Kev1n8088/OshTeledongle/OshTeledongle.kicad_pcb

## KiCad design OshTeledongle.kicad_pcb (2026-07-14)

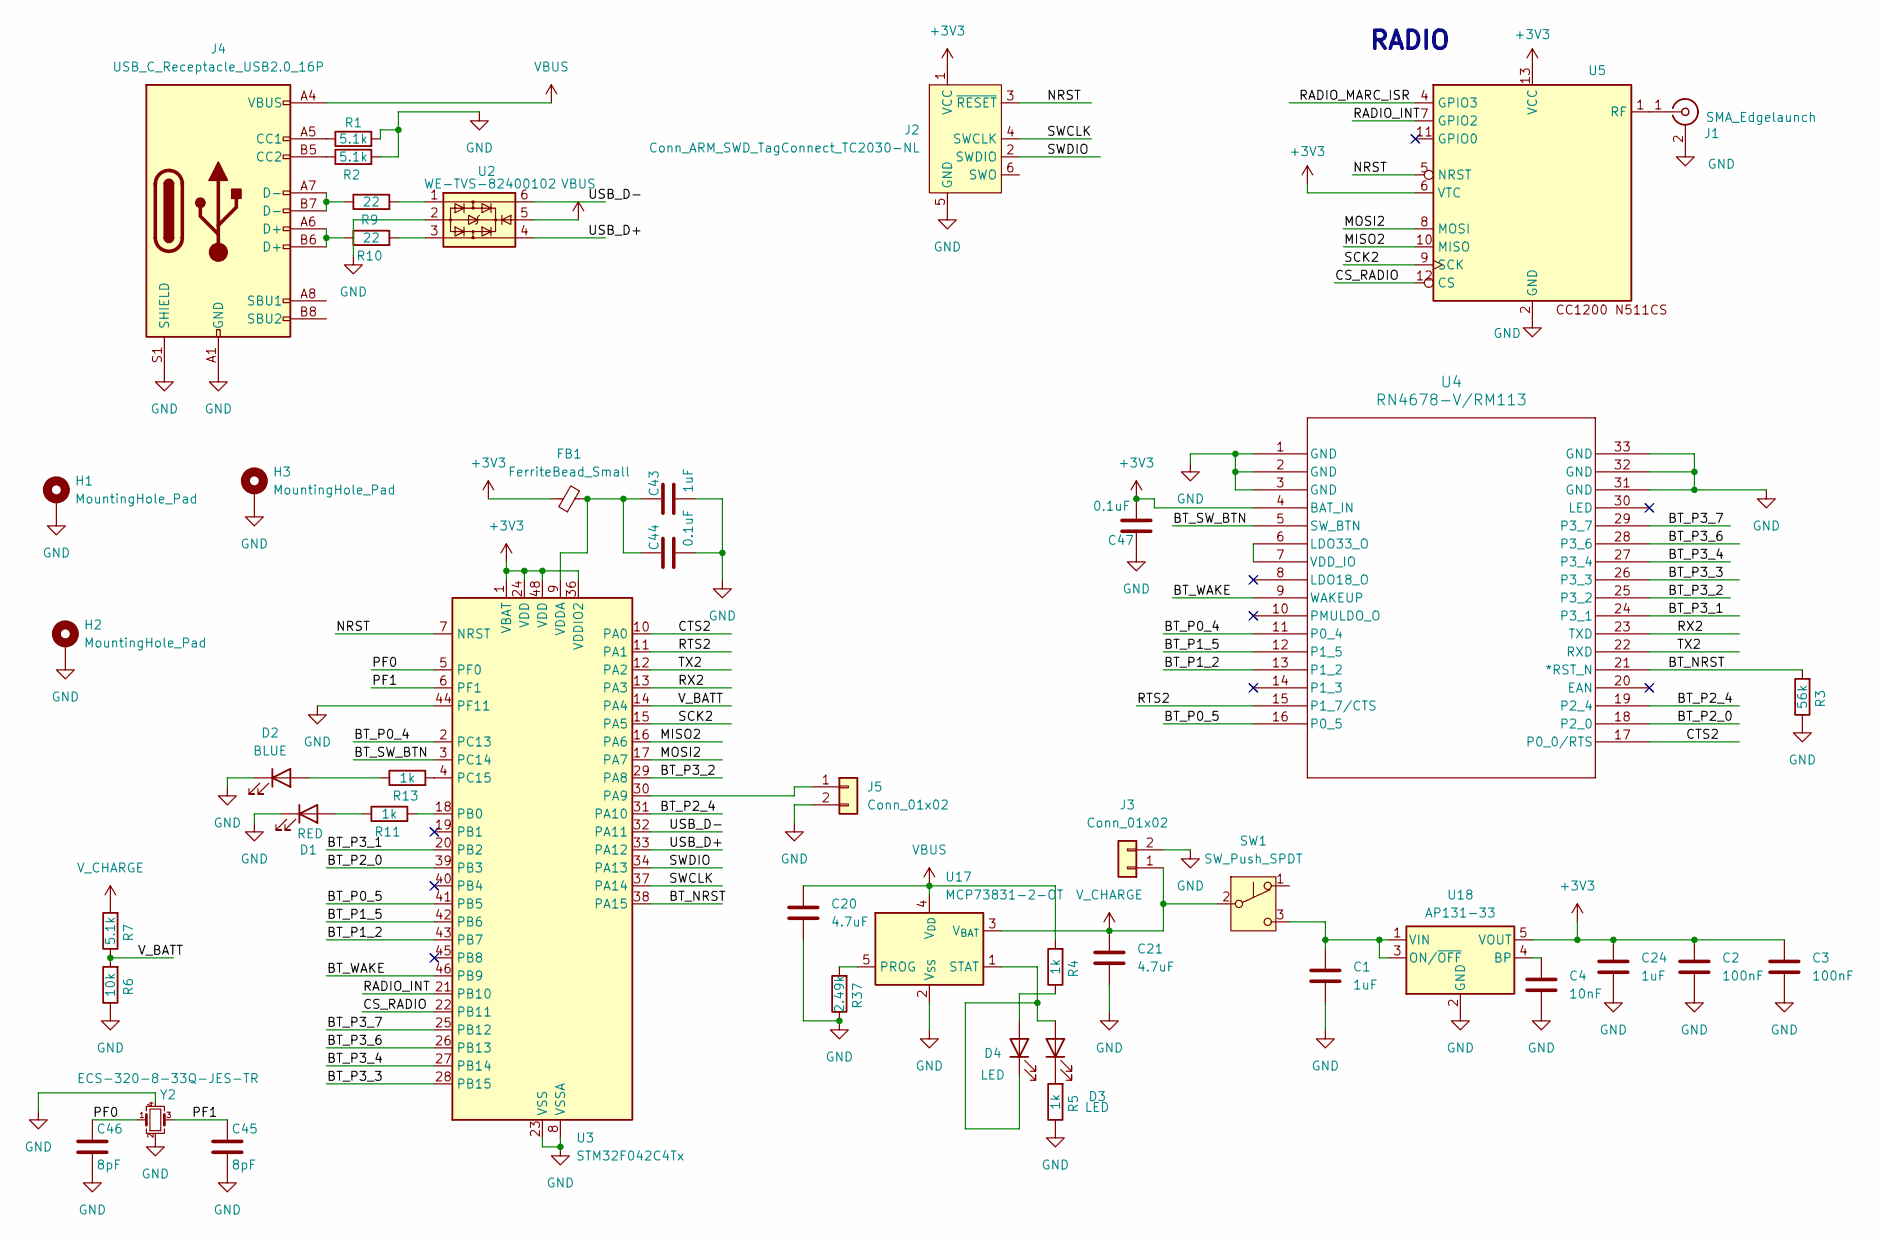
[picture p1: schematic OshTeledongle.kicad_sch]

Parts:
C1, C24, C43: 1uF; C_0402_1005Metric
C2, C3: 100nF; C_0402_1005Metric
C4: 10nF; C_0402_1005Metric
C20, C21: 4.7uF; C_0402_1005Metric
C44, C47: 0.1uF; C_0402_1005Metric
C45, C46: 8pF; C_0402_1005Metric
D1: RED; LED_0603_1608Metric
D2: BLUE; LED_0603_1608Metric
D3, D4: LED; LED_0603_1608Metric
FB1: FerriteBead_Small; L_0402_1005Metric
H1, H2, H3: MountingHole_Pad; MountingHole_3.2mm_M3_DIN965_Pad
J1: SMA_Edgelaunch; SMA_Amphenol_132289_EdgeMount
J2: Conn_ARM_SWD_TagConnect_TC2030-NL; Tag-Connect_TC2030-IDC-NL_2x03_P1.27mm_Vertical
J3: Conn_01x02; JST_PH_S2B-PH-K_1x02_P2.00mm_Horizontal
J4: USB_C_Receptacle_USB2.0_16P; USB_C_Receptacle_GCT_USB4105-xx-A_16P_TopMnt_Horizontal
J5: Conn_01x02; PinHeader_1x02_P2.54mm_Vertical
R1, R2, R7: 5.1k; R_0402_1005Metric
R3: 56k; R_0402_1005Metric
R4, R5, R11, R13: 1k; R_0402_1005Metric
R6: 10k; R_0402_1005Metric
R9, R10: 22; R_0402_1005Metric
R37: 2.49k; R_0402_1005Metric
SW1: SW_Push_SPDT; SW_E-Switch_EG1224_SPDT_Angled
U2: WE-TVS-82400102; SOT-23-6
U3: STM32F042C4Tx; LQFP-48_7x7mm_P0.5mm
U4: RN4678-V/RM113; RN4678_MCH
U5: N511CS
U17: MCP73831-2-OT; SOT-23-5
U18: AP131-33; SOT-23-5
Y2: ECS-320-8-33Q-JES-TR; Crystal_SMD_Abracon_ABM8G-4Pin_3.2x2.5mm

Connections:
+3V3: C2.2, C3.2, C24.2, C47.1, FB1.1, J2.1 (VCC), U3.1 (VBAT), U3.24 (VDD), U3.36 (VDDIO2), U3.48 (VDD), U4.4 (BAT_IN), U5.6 (VTC), U5.13 (VCC), U18.5 (VOUT)
/BT_NRST: R3.2, U3.38 (PA15), U4.21 (*RST_N)
/BT_P0_4: U3.2 (PC13), U4.11 (P0_4)
/BT_P0_5: U3.41 (PB5), U4.16 (P0_5)
/BT_P1_2: U3.43 (PB7), U4.13 (P1_2)
/BT_P1_5: U3.42 (PB6), U4.12 (P1_5)
/BT_P2_0: U3.39 (PB3), U4.18 (P2_0)
/BT_P2_4: U3.31 (PA10), U4.19 (P2_4)
/BT_P3_1: U3.20 (PB2), U4.24 (P3_1)
/BT_P3_2: U3.29 (PA8), U4.25 (P3_2)
/BT_P3_3: U3.28 (PB15), U4.26 (P3_3)
/BT_P3_4: U3.27 (PB14), U4.27 (P3_4)
/BT_P3_6: U3.26 (PB13), U4.28 (P3_6)
/BT_P3_7: U3.25 (PB12), U4.29 (P3_7)
/BT_SW_BTN: U3.3 (PC14), U4.5 (SW_BTN)
/BT_WAKE: U3.46 (PB9), U4.9 (WAKEUP)
/CS_RADIO: U3.22 (PB11), U5.12 (CS)
/CTS2: U3.10 (PA0), U4.17 (P0_0/RTS)
/MISO2: U3.16 (PA6), U5.10 (MISO)
/MOSI2: U3.17 (PA7), U5.8 (MOSI)
/NRST: J2.3 (~RESET), U3.7 (NRST), U5.5 (NRST)
/PF0: C46.2, U3.5 (PF0), Y2.1
/PF1: C45.2, U3.6 (PF1), Y2.3
/RADIO_INT: U3.21 (PB10), U5.7 (GPIO2)
/RADIO_MARC_ISR: U5.4 (GPIO3)
/RTS2: U3.11 (PA1), U4.15 (P1_7/CTS)
/RX2: U3.13 (PA3), U4.23 (TXD)
/SCK2: U3.15 (PA5), U5.9 (SCK)
/SWCLK: J2.4 (SWCLK), U3.37 (PA14)
/SWDIO: J2.2 (SWDIO), U3.34 (PA13)
/TX2: U3.12 (PA2), U4.22 (RXD)
/USB_D+: U2.4, U3.33 (PA12)
/USB_D-: U2.6, U3.32 (PA11)
/V_BATT: R6.2, R7.1, U3.14 (PA4)
GND: C1.1, C2.1, C3.1, C4.1, C20.1, C21.1, C24.1, C43.1, C44.1, C45.1, C46.1, C47.2, D1.1 (K), D2.1 (K), H1.1, H2.1, H3.1, J1.2 (Ext), J2.5 (GND), J3.2, J4.A1 (GND), J4.A12 (GND), J4.B1 (GND), J4.B12 (GND), J4.S1 (SHIELD), J5.2, R1.2, R2.2, R3.1, R5.1, R6.1, R37.1, U2.2, U3.8 (VSSA), U3.23 (VSS), U3.35 (VSS), U3.44 (PF11), U3.47 (VSS), U4.1 (GND), U4.2 (GND), U4.3 (GND), U4.31 (GND), U4.32 (GND), U4.33 (GND), U5.2 (GND), U5.3 (GND), U5.14 (GND), U17.2 (V_{SS}), U18.2 (GND), Y2.2, Y2.4
unnamed: D1.2 (A), R11.1
unnamed: D2.2 (A), R13.1
unnamed: D3.2 (A), D4.1 (K), U17.1 (STAT)
unnamed: D3.1 (K), R5.2
unnamed: D4.2 (A), R4.1
unnamed: J1.1 (In), U5.1 (RF)
unnamed: J4.A5 (CC1), R1.1
unnamed: J4.B5 (CC2), R2.1
unnamed: J4.A6 (D+), J4.B6 (D+), R10.1
unnamed: J4.A7 (D-), J4.B7 (D-), R9.1
unnamed: J5.1, U3.30 (PA9)
unnamed: R9.2, U2.1
unnamed: R10.2, U2.3
unnamed: C1.2, SW1.3 (C), U18.1 (VIN), U18.3 (ON/~OFF)
unnamed: R11.2, U3.18 (PB0)
unnamed: R13.2, U3.4 (PC15)
unnamed: C43.2, C44.2, FB1.2, U3.9 (VDDA)
unnamed: U4.6 (LDO33_O), U4.7 (VDD_IO)
unnamed: R37.2, U17.5 (PROG)
unnamed: C4.2, U18.4 (BP)
VBUS: C20.2, J4.A4 (VBUS), J4.A9 (VBUS), J4.B4 (VBUS), J4.B9 (VBUS), R4.2, U2.5, U17.4 (V_{DD})
V_CHARGE: C21.2, J3.1, R7.2, SW1.2 (B), U17.3 (V_{BAT})

Notes on the sheet:
RADIO

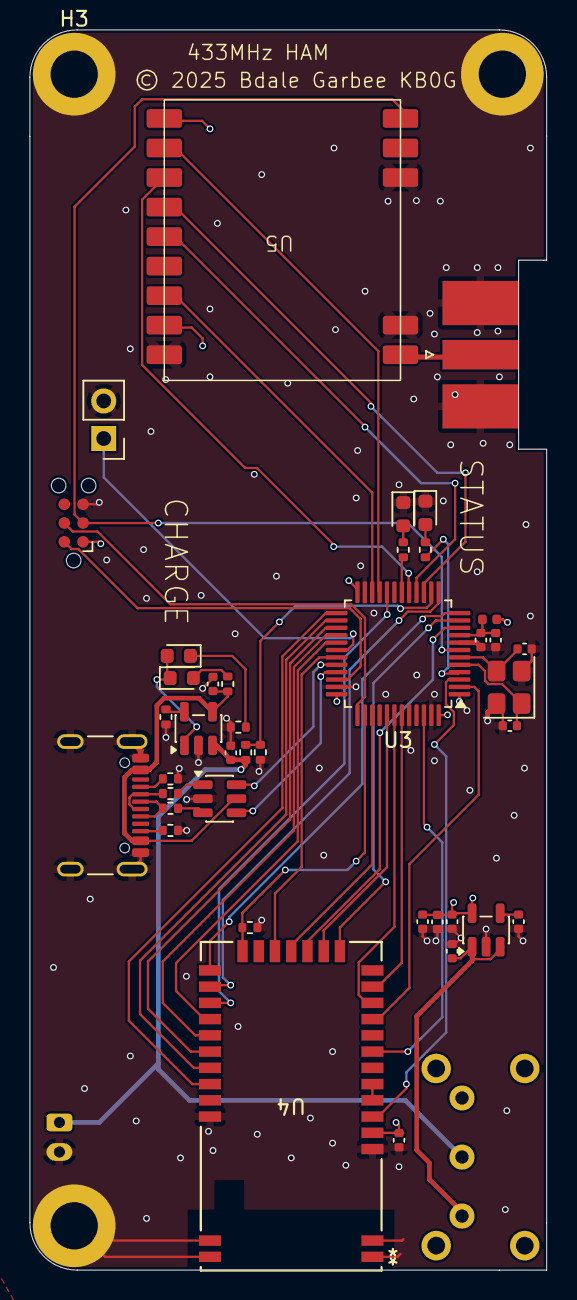
[picture p2: board OshTeledongle.kicad_pcb from above]

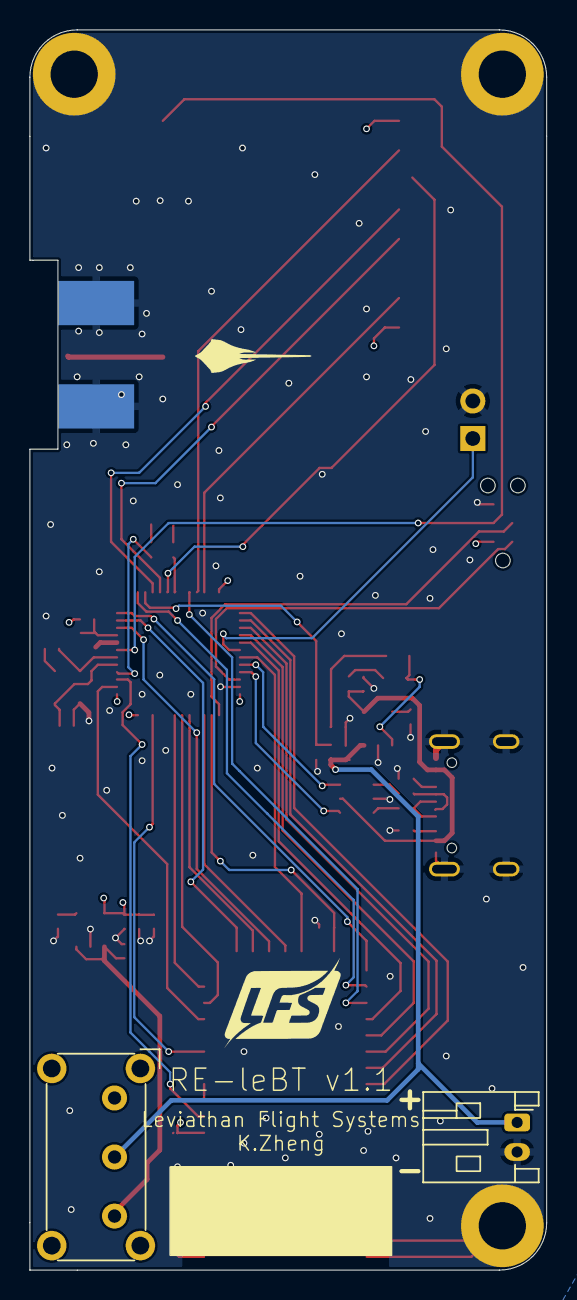
[picture p3: board OshTeledongle.kicad_pcb from below]

Board: 4 copper layers, 35.0 x 84.0 mm, 45 parts (2 on the bottom side), 56 nets.
