Kev1n8088/OshTeledongle/(commit log)

2025-10-20 v1.0 done
    [OshTeledongle.kicad_pcb, OshTeledongle.kicad_sch]
2026-05-18 v1.0 sent to fab
    [BOM-OshTeledongle.csv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]
2026-07-14 v1.1 release, fixed a spi pin disconnected, should be good for mass prod now
    [OshTeledongle.kicad_pcb, OshTeledongle.kicad_sch]
