Kev1n8088/OshTeledongle/(notices)

Notices in the files:
OshTeledongle.kicad_pcb:
© 2025 Bdale Garbee KB0G
